koliazak/ebaz4205-FM/docs/ConnectingDiagram.pdf

5V

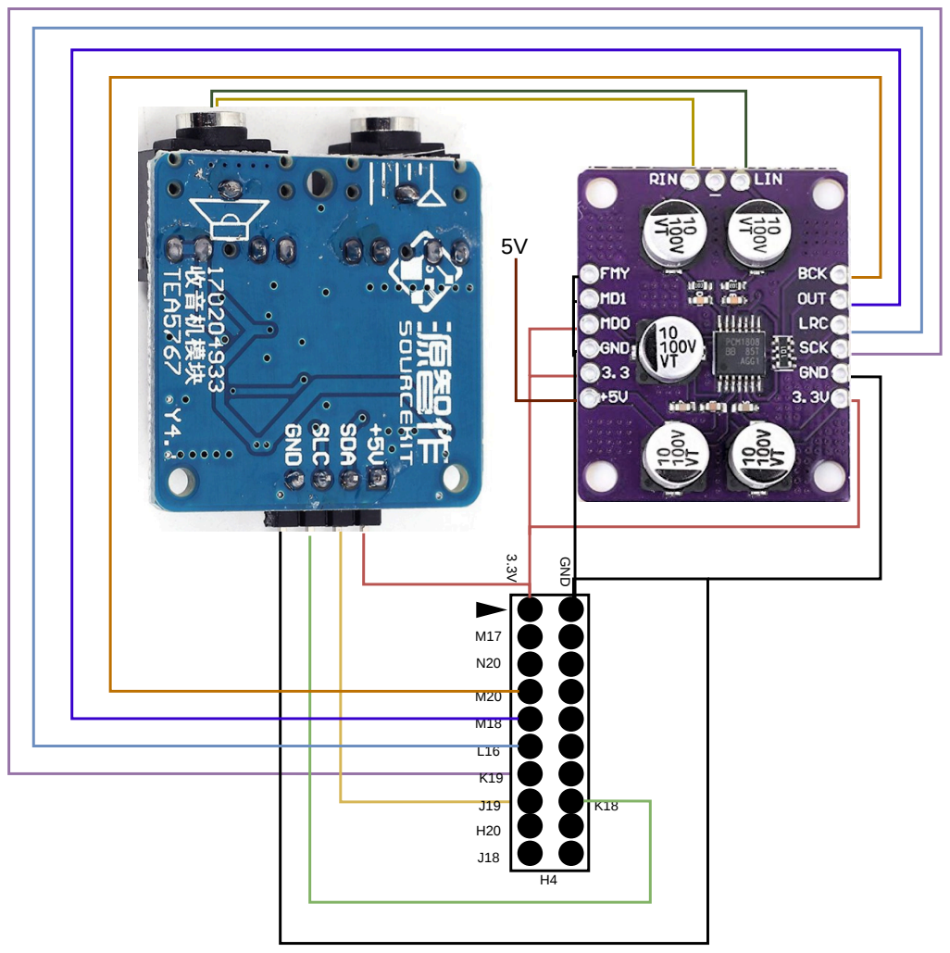
[picture p1: page 1]
GND
