koliazak/ebaz4205-FM/docs/ebaz4205-system-bd.pdf

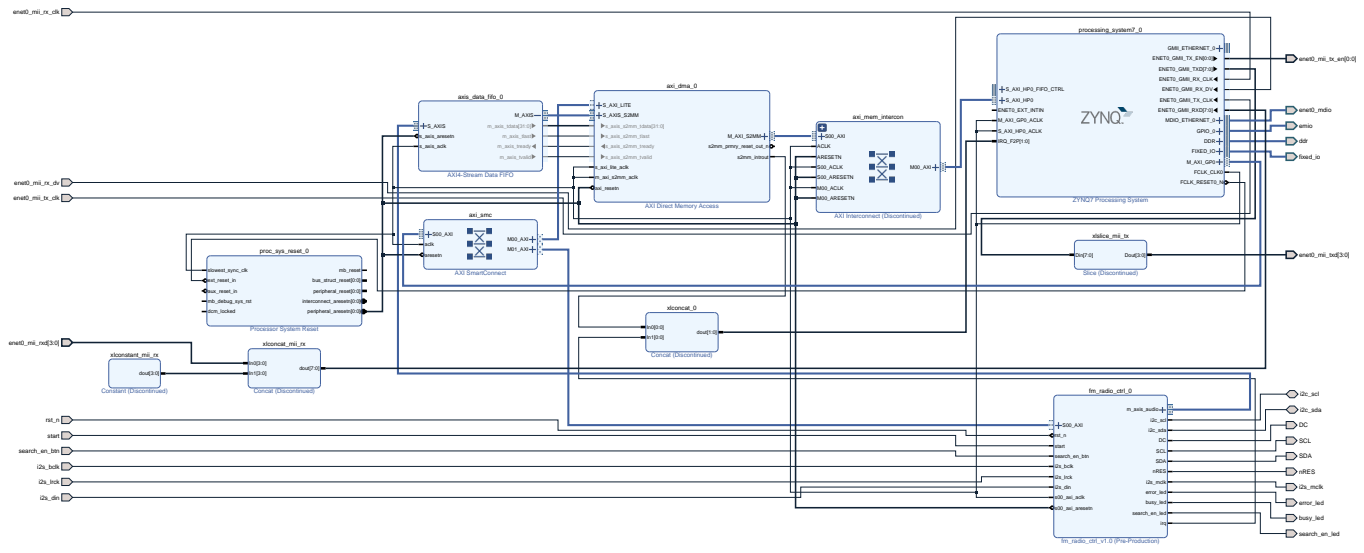
[picture p2: page 1]
axi_dma_0; S_AXI_LITE; M_AXI_S2MM; S_AXIS_S2MM; s_axis_s2mm_tdata[31:0]; s_axis_s2mm_tlast; s_axis_s2mm_tready; s_axis_s2mm_tvalid; s_axi_lite_aclk m_axi_s2mm_aclk axi_resetn; s2mm_prmry_reset_out_n; s2mm_introut; axi_mem_intercon; S00_AXI; M00_AXI; ACLK; ARESETN; S00_ACLK; S00_ARESETN M00_ACLK M00_ARESETN; axi_smc; AXI SmartConnect; M00_AXI M01_AXI aclk aresetn; axis_data_fifo_0; S_AXIS; M_AXIS m_axis_tdata[31:0] m_axis_tlast m_axis_tready m_axis_tvalid; s_axis_aresetn; s_axis_aclk; ddr; emio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

AXI4-Stream Data FIFO

AXI Direct Memory Access

AXI Interconnect (Discontinued)

Processor System Reset
