koliazak/ebaz4205-FM/hw/ip_repo/fm_radio_ctrl_v1_0/hdl/bin_to_bcd.v

module bin_to_bcd
  (
   input        clk,
   input        rst_n,

   input        en,
   input [15:0] bin,

   output [3:0] bcd0,
   output [3:0] bcd1,
   output [3:0] bcd2,
   output [3:0] bcd3,
   output [3:0] bcd4,

   output       busy,
   output       fin
   );

   reg [15:0]   bin_r;
   reg [3:0]    bitcount;
   reg [3:0]    bcd[0:4];
   wire [3:0]   bcdp[0:4];

   assign bcd0 = bcd[0];
   assign bcd1 = bcd[1];
   assign bcd2 = bcd[2];
   assign bcd3 = bcd[3];
   assign bcd4 = bcd[4];

   localparam s_idle = 2'b00;
   localparam s_busy = 2'b01;
   localparam s_fin  = 2'b10;
   reg [1:0]    state;
   
   assign busy = state != s_idle;
   assign fin  = state == s_fin;

   always @(posedge clk)
     if (!rst_n) begin
        state <= s_idle;
     end else begin
        case (state)
          s_idle: 
            if (en)
              state <= s_busy;

          s_busy:
            if (bitcount == 4'd15)
              state <= s_fin;

          s_fin:
            state <= s_idle;

          default: ;
        endcase
     end

   always @(posedge clk) begin
      case (state)
        s_idle: 
          if (en)
            bin_r <= bin;
        s_busy:
          bin_r <= {bin_r[14:0], 1'b0};
        default: ;
      endcase
   end

   always @(posedge clk)
     if (!rst_n) begin
        bitcount <= 4'd0;
     end else begin
        case (state)
          s_busy: 
            bitcount <= bitcount + 4'd1;

          default: 
            bitcount <= 4'd0;
        endcase
     end

   generate
      genvar g;

      for (g=0; g<=4; g=g+1) begin : GEN_BCD

         wire [3:0] s;
         wire [3:0] prev;

         assign bcdp[g] = (bcd[g] >= 4'd5) ? bcd[g] + 4'd3 : bcd[g];

         if (g != 0) begin
            assign prev = bcdp[g-1];
         end else begin // if (g != 0)
            assign prev = {bin_r[15], 3'b0};
         end
         assign s 
           = ((bcdp[g] << 1) | (prev >> 3));

         always @(posedge clk)
           if (!rst_n) begin
              bcd[g] <= 4'd0;
           end else begin
              case (state)
                s_idle: 
                  bcd[g] <= 4'd0;

                s_busy:
                  bcd[g] <= s;

                default: ;
              endcase
           end

      end
   endgenerate

endmodule
