koliazak/ebaz4205-FM/(commit log)

2026-03-29 Basic interaction with tea5767 module via buttons & show current station on display
2026-04-05 Added G.711 A-Law encoder module
2026-04-13 update I2S interface for ADC master clocking
2026-04-22 update device tree for new fm_radio_ctrl AXI address
2026-04-24 add documentation for device-server-client communication
2026-04-25 fix search mode issues
    [fm_radio_ctrl.v, fm_radio_ctrl_slave_lite_v1_0_S00_AXI.v, fm_tea5767.v, top.v]
2026-04-25 add logic for device auth
2026-04-26 add code for device client
2026-04-27 add module to control FPGA device via registers
2026-04-27 add logic for handling interrupts from FPGA, bug fixes
